pollen-robotics/elec_battery_mngt/README.md

# Battery-related Electronic Boards

This repository gathers several small PCBs for battery management. Including:

 - 2S BMS + USB-ish charger

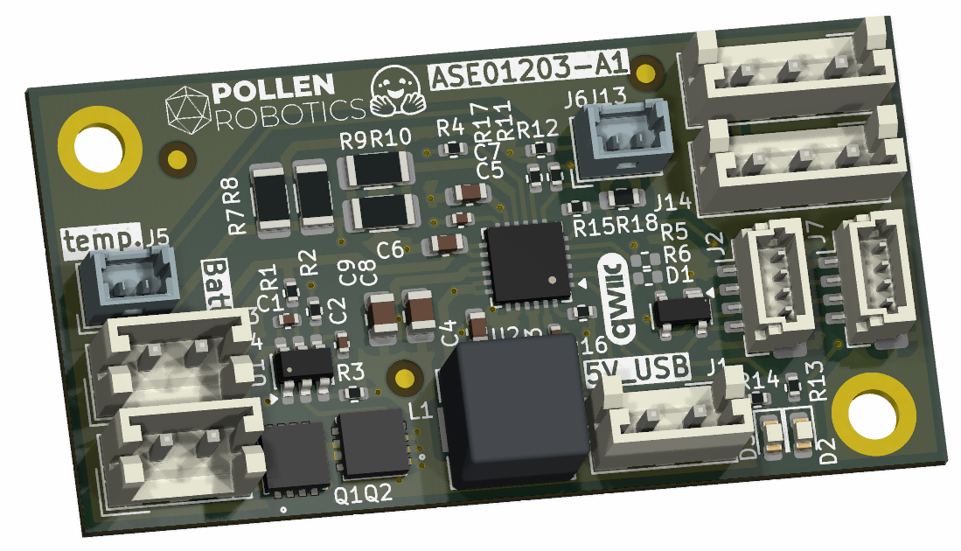
[picture p1: elec_2S_BMS_plus_charger/docs/img/elec_2S_BMS_plus_charger.png]
3d view


## Basically
 - Designed with KiCAD 9.
