pollen-robotics/elec_battery_mngt/elec_2S_BMS_plus_charger/docs/img/running.jpg

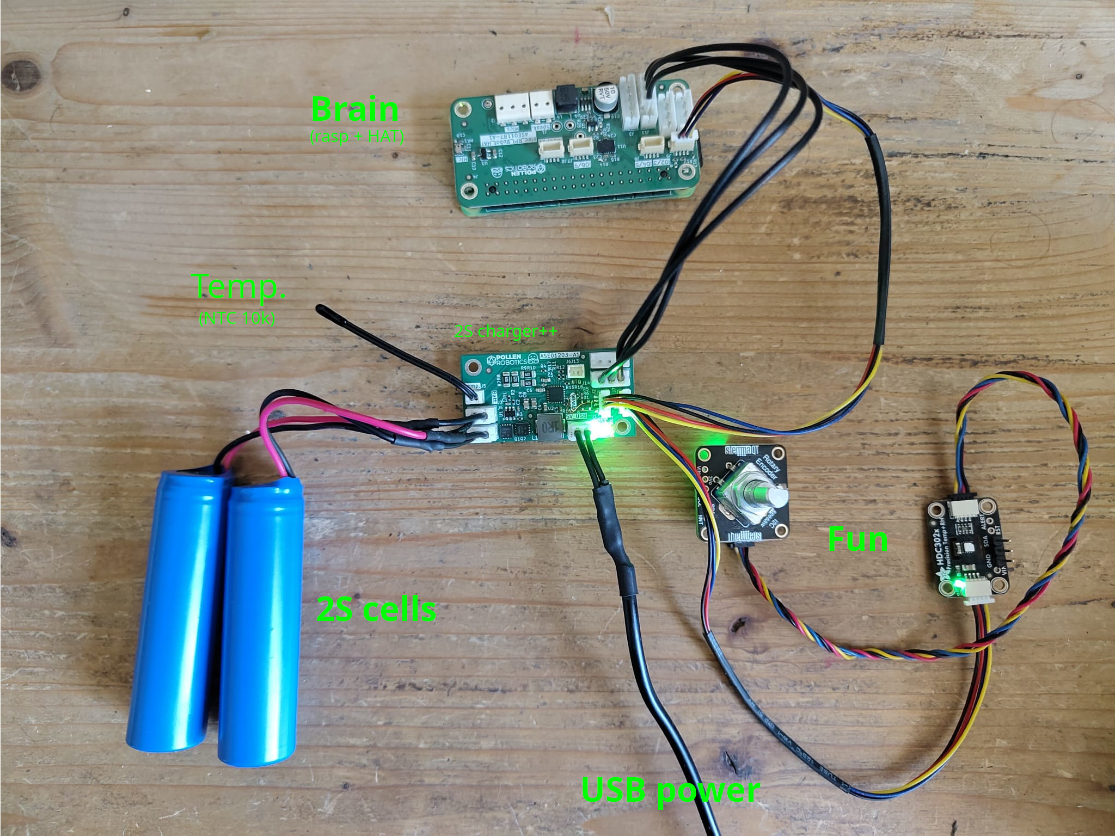
elec_2S_BMS_plus_charger/docs/img/running.jpg
