pollen-robotics/elec_battery_mngt/elec_2S_BMS_plus_charger/fab/elec_BMS_plus_charger.step

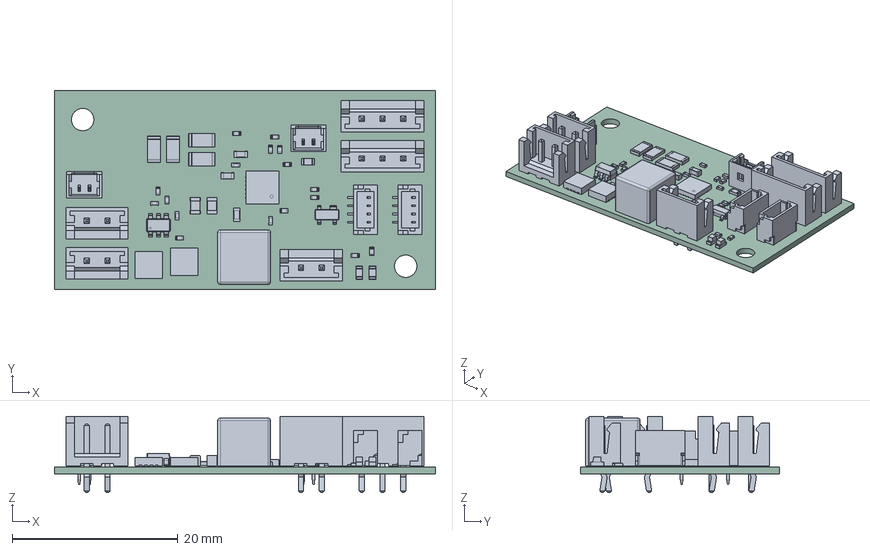
[picture p4: CAD file, 2026-04-30]
elec_2S_BMS_plus_charger/fab/elec_BMS_plus_charger.step
46.0 x 24.0 x 9.20 mm
R_1206_3216Metric x 4
LED_0603_1608Metric x 2
JST_EH_B2B-EH-A_1x02_P2.50mm_Vertical x 3
Molex_530470210 x 2
C_0805_2012Metric x 2
JST_SH_BM04B-SRSS-TB_1x04-1MP_P1.00mm_Vertical x 2
R_0402_1005Metric x 13
L_Bourns_SRP6060FA
SOT-23-6
C_0603_1608Metric x 3
BSZ034N04LS x 2
C_0402_1005Metric x 4
R_0603_1608Metric
Texas_RGE0024H_VQFN-24-1EP_4x4mm_P0.5mm_EP2.7x2.7mm
SOT-143
JST_EH_B3B-EH-A_1x03_P2.50mm_Vertical x 2
elec_BMS_plus_charger_PCB
