pollen-robotics/elec_battery_mngt/elec_2S_BMS_plus_charger/fab/elec_BMS_plus_charger.pdf

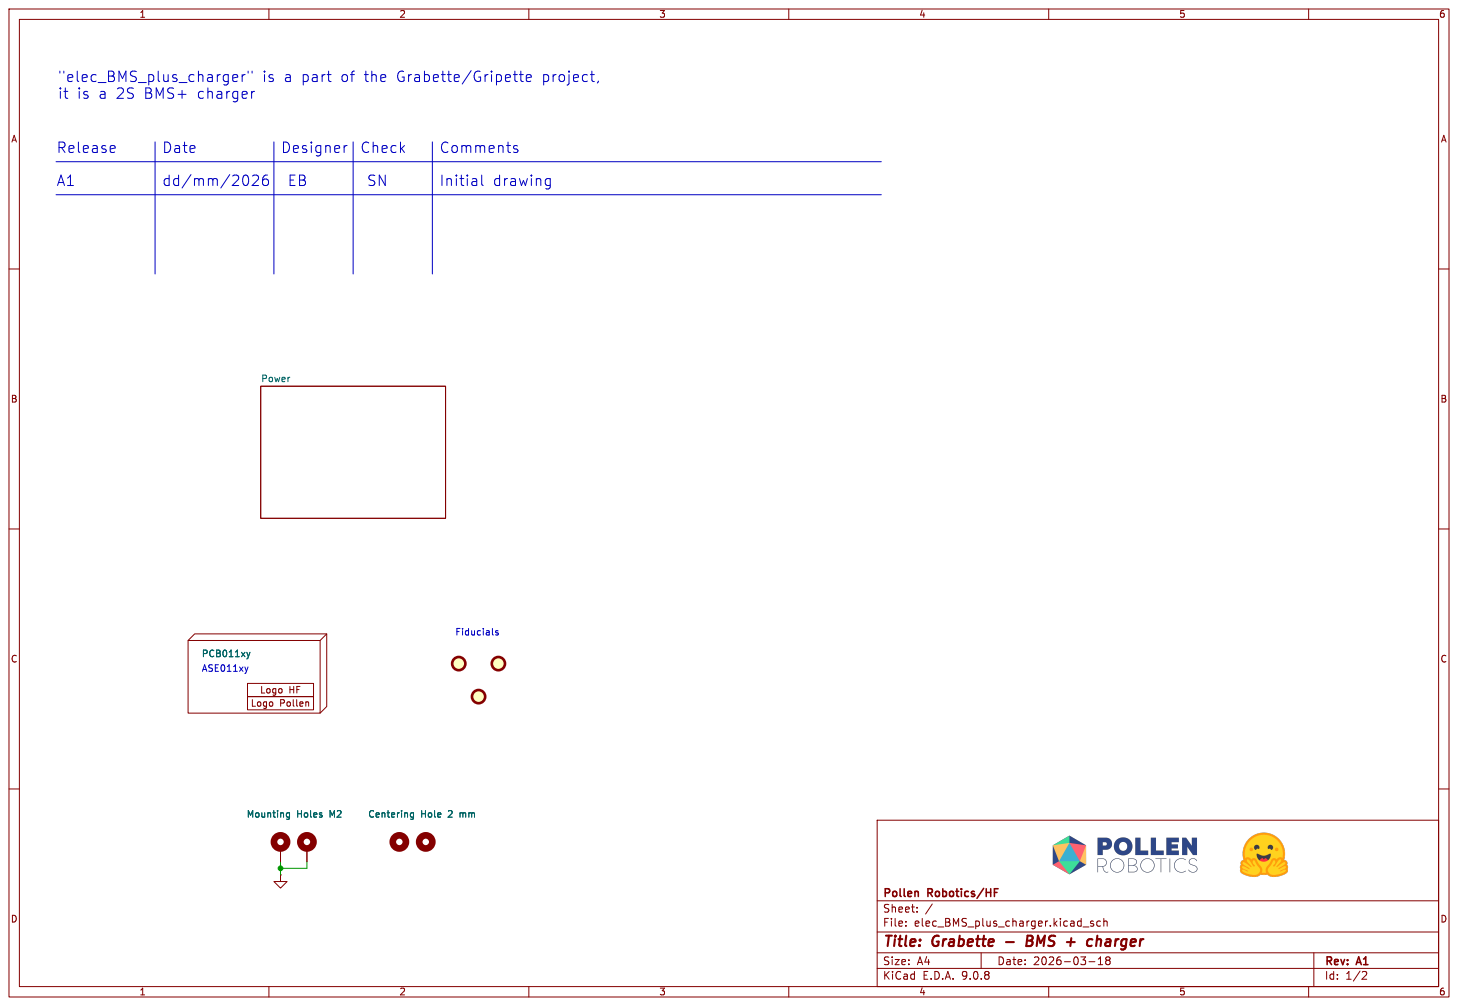
[picture p5: page 1]

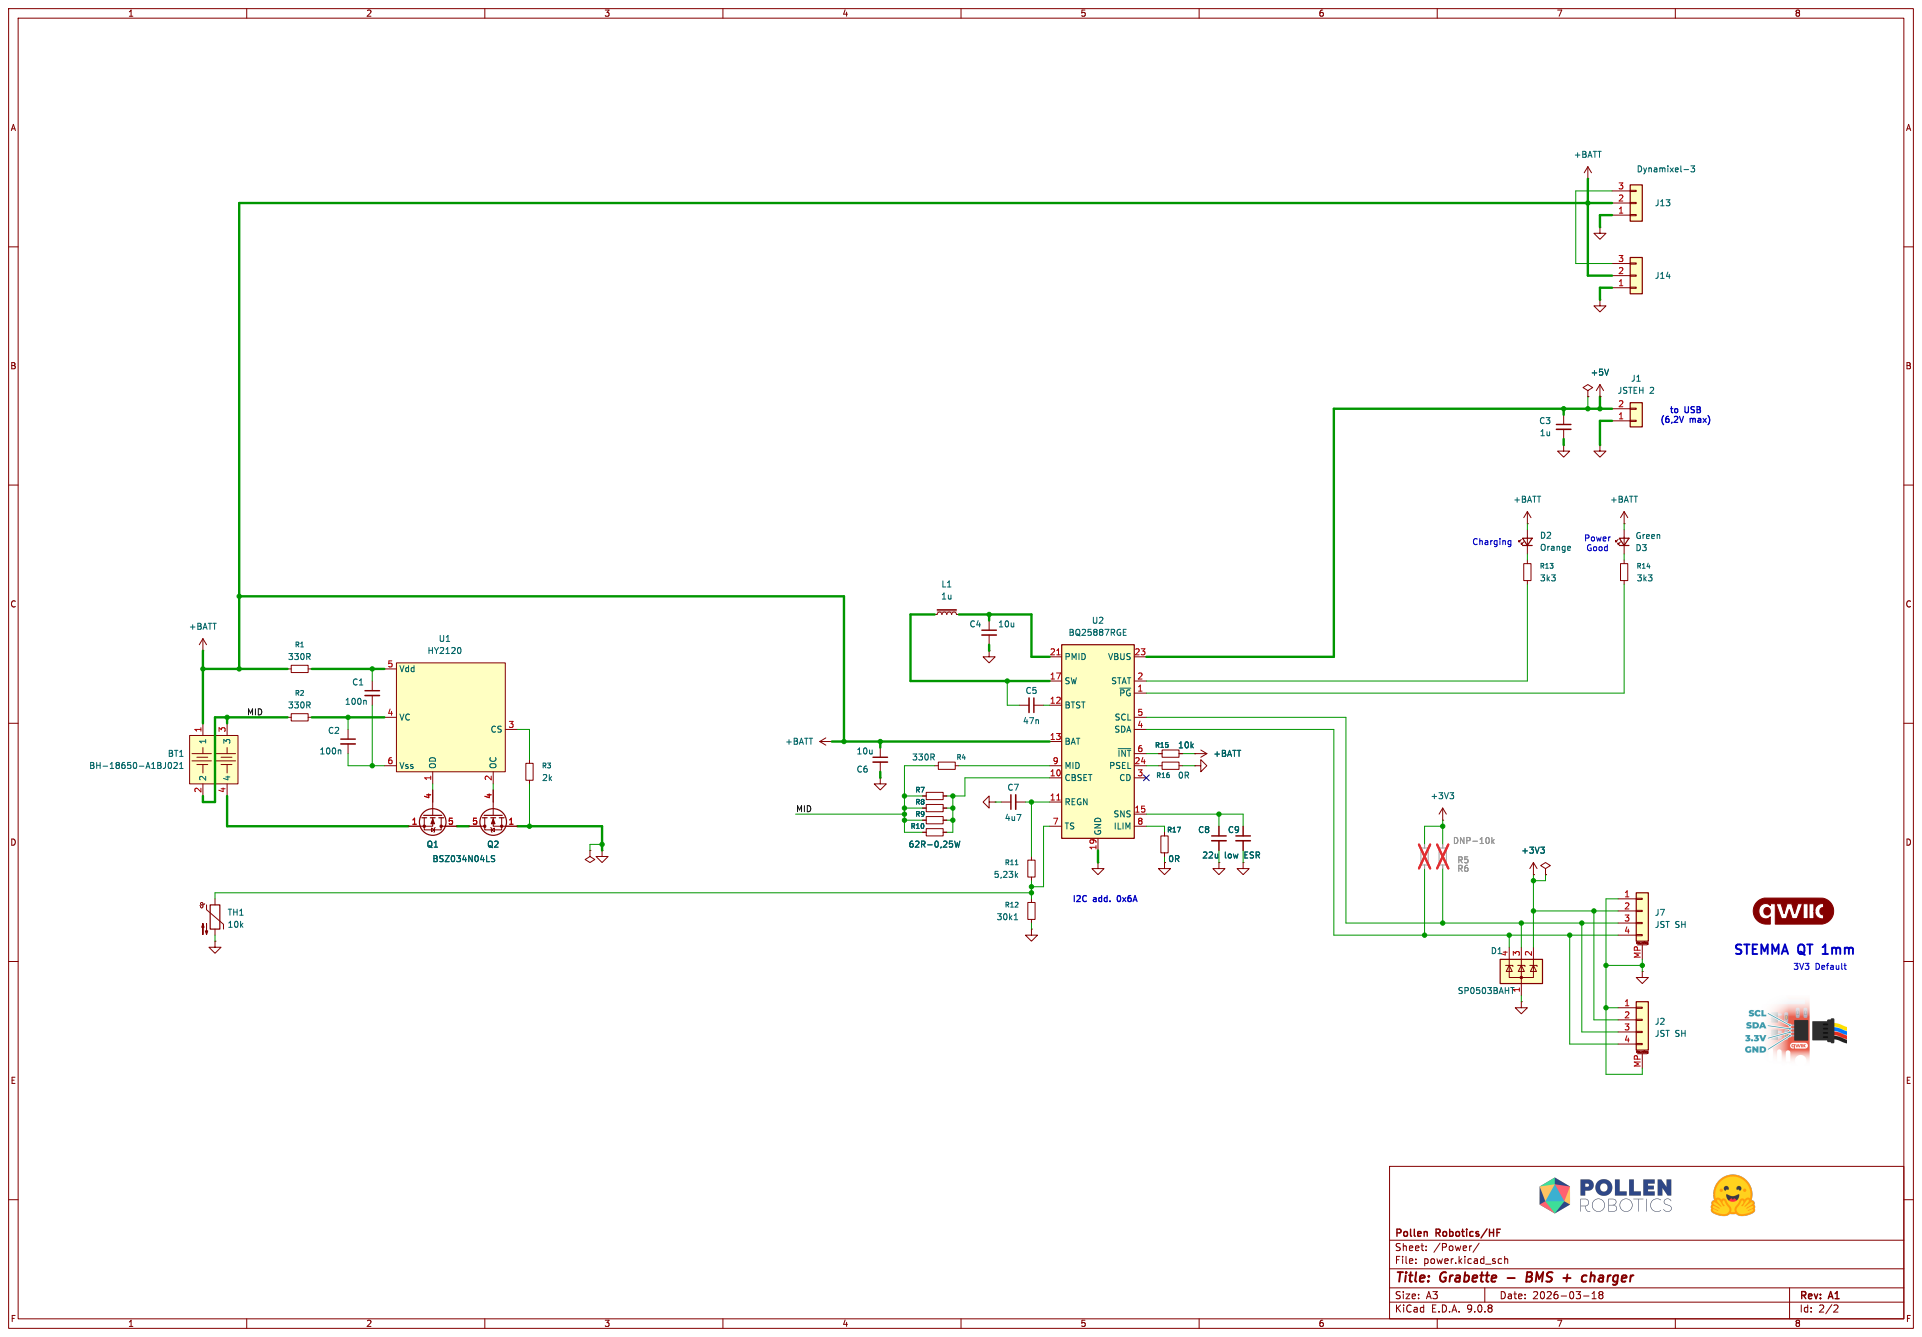
[picture p6: page 2]
