pollen-robotics/elec_battery_mngt/elec_2S_BMS_plus_charger/elec_BMS_plus_charger.kicad_pcb

## KiCad design elec_2S_BMS_plus_charger/elec_BMS_plus_charger.kicad_pcb (2026-08-10)

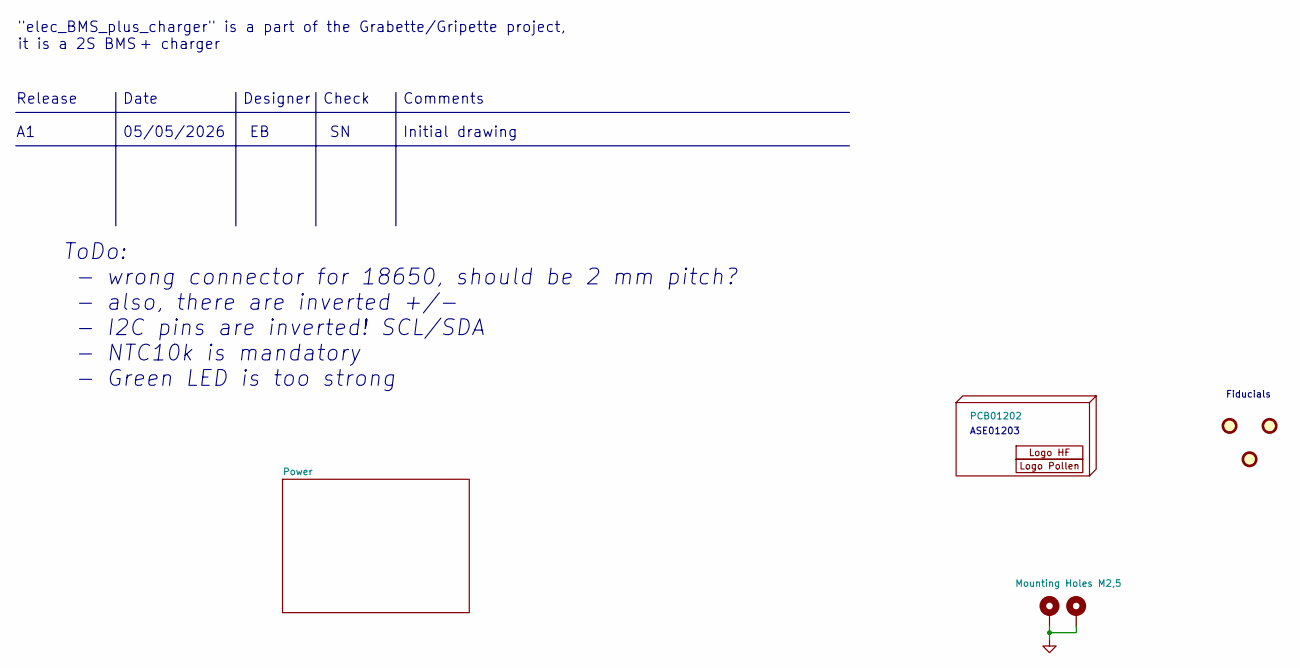
[picture p7: schematic elec_BMS_plus_charger.kicad_sch, Grabette - BMS + charger]

Parts:
FID1, FID2, FID3: DNP Fiducial; Fiducial_1mm_Mask2mm
H1: PCB01202
H2: Logo HF 2025; Logo_HF_2025
H3: DNP Logo Pollen 2021; Logo_Pollen_2021_sq
H4, H5: Mounting Holes M2,5; MountingHole_2.7mm_M2.5_ISO7380_Pad_TopBottom

Connections:
GND: H4.1, H5.1; also elsewhere on the board

Notes on the sheet:
Date
Check
Release
Fiducials
ASE01203
ToDo: - wrong connector for 18650, should be 2 mm pitch? - also, there are inverted +/- - I2C pins are inverted! SCL/SDA - NTC10k is mandatory - Green LED is too strong
Initial drawing
"elec_BMS_plus_charger" is a part of the Grabette/Gripette project, it is a 2S BMS + charger
Designer
Comments
05/05/2026

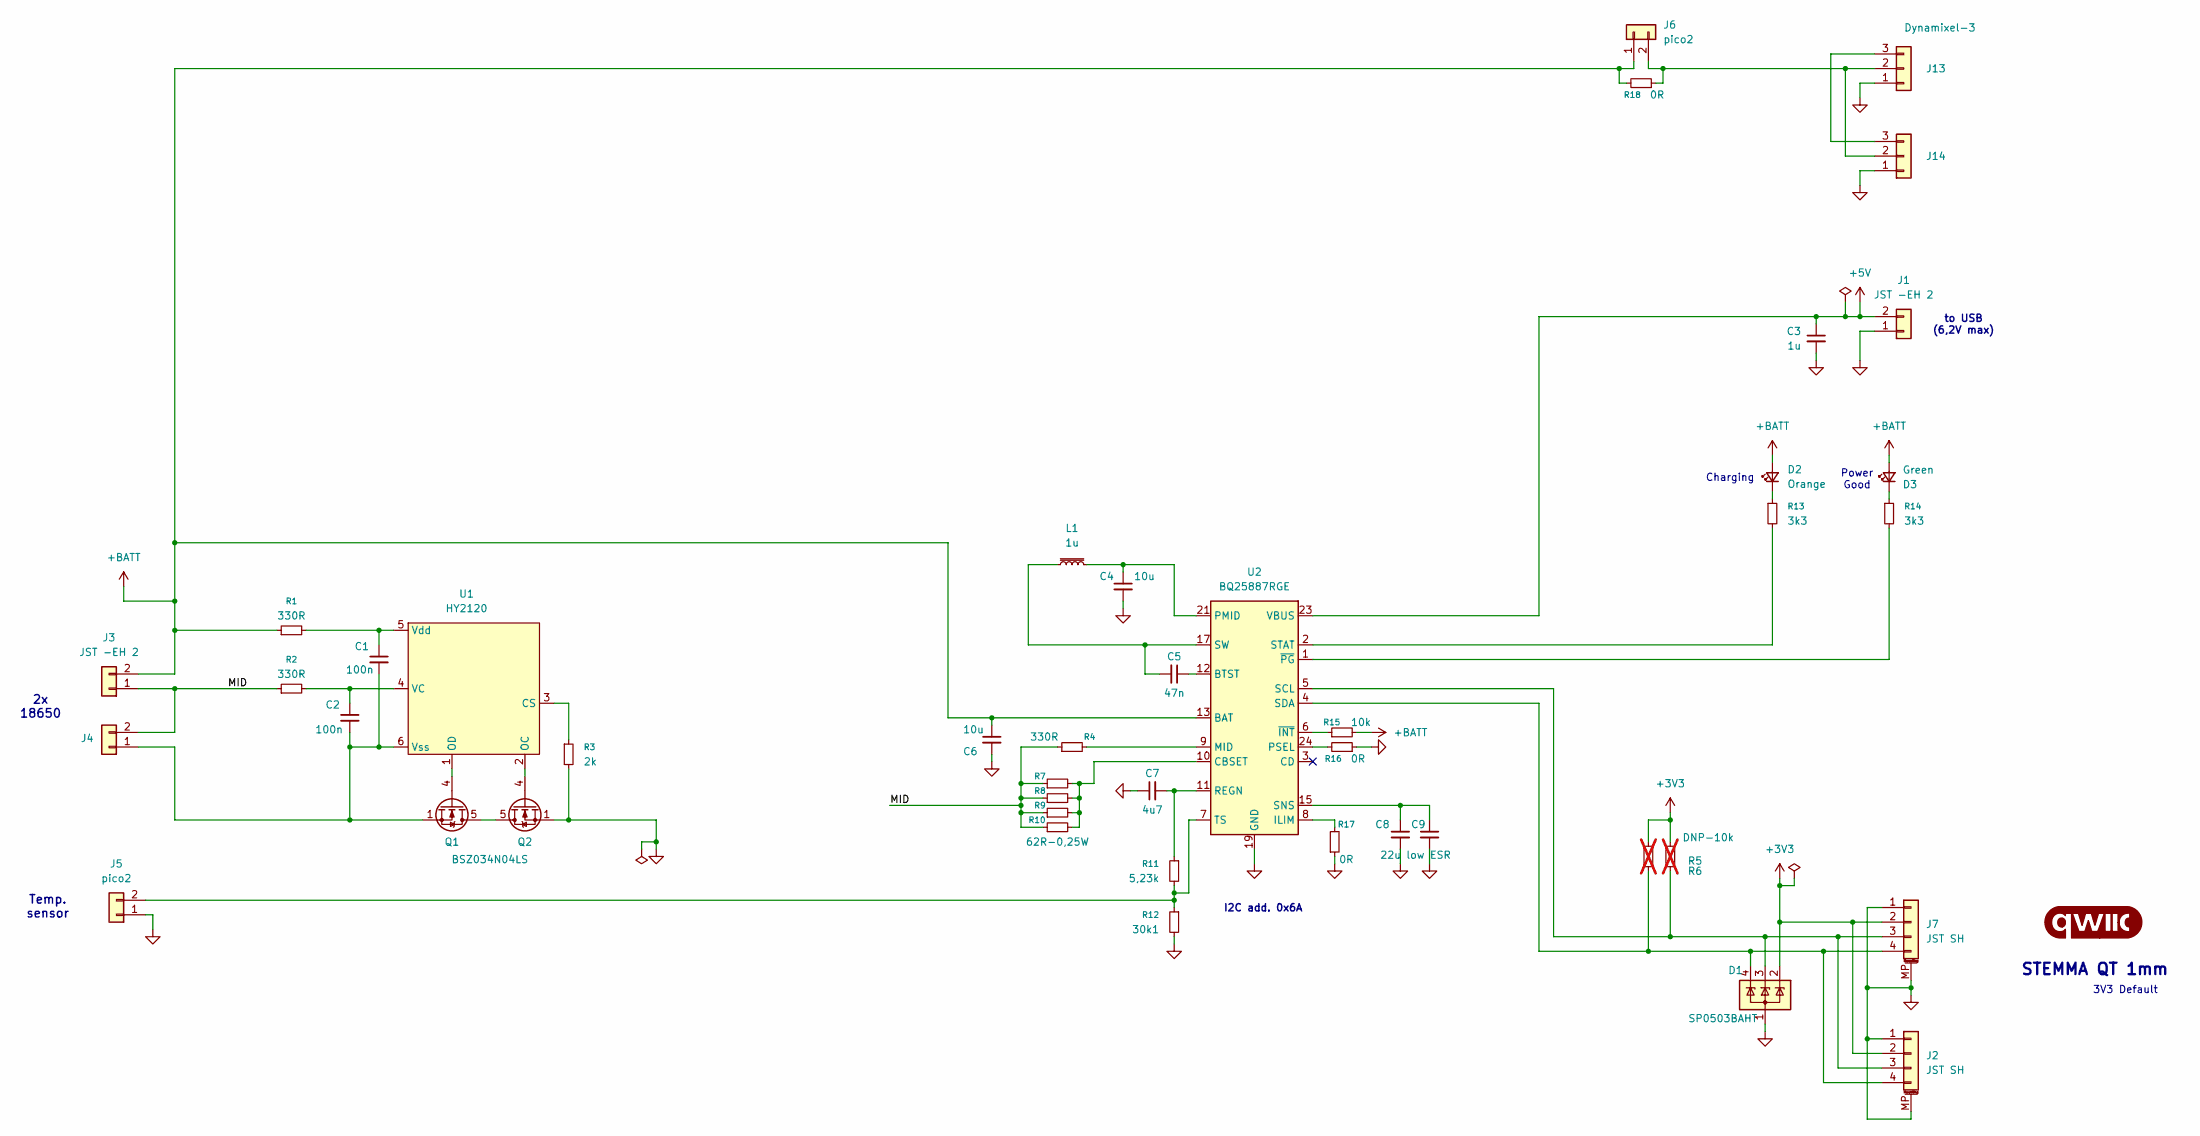
[picture p8: schematic power.kicad_sch, Grabette - BMS + charger]

Parts:
C1, C2: 100n; C_0402_1005Metric; LCSC Part C1525
C3: 1u; C_0402_1005Metric; LCSC Part C52923
C4, C6: 10u; C_0603_1608Metric; LCSC Part C19702
C5: 47n; C_0402_1005Metric; LCSC Part C272875
C7: 4u7; C_0603_1608Metric; LCSC Part C1705
C8, C9: 22u low ESR; C_0805_2012Metric; LCSC Part C5674
D1: SP0503BAHT; SOT-143; LCSC Part C41364459
D2: Orange; LED_0603_1608Metric; LCSC Part C84269
D3: Green; LED_0603_1608Metric; LCSC Part C19171301
G1: qwiic_Logo; Logo_qwiic_5mm
J1, J3, J4: JST -EH 2; JST_EH_B2B-EH-A_1x02_P2.50mm_Vertical; LCSC Part C160262
J2, J7: JST SH; JST_SH_BM04B-SRSS-TB_1x04-1MP_P1.00mm_Vertical; LCSC Part C160390
J5, J6: pico2; Molex_PicoBlade_53047-0210_1x02_P1.25mm_Vertical; LCSC Part C114130
J13, J14: Dynamixel-3; JST_EH_B3B-EH-A_1x03_P2.50mm_Vertical; LCSC Part C160259
L1: 1u; IND-SMD_L7.2-W6.6_GPSR0730; LCSC Part C5189744
Q1, Q2: BSZ034N04LS; PQFN_3.3x3.3mm_-_PG-TDSON-8_FL; LCSC Part C534652
R1, R2, R4: 330R; R_0402_1005Metric; LCSC Part C25104
R3: 2k; R_0402_1005Metric; LCSC Part C2909344
R5, R6: DNP-10k; R_0402_1005Metric; not fitted
R7, R8, R9, R10: 62R-0,25W; R_1206_3216Metric; LCSC Part C3013271
R11: 5,23k; R_0402_1005Metric; LCSC Part C2933105
R12: 30k1; R_0402_1005Metric; LCSC Part C2998131
R13, R14: 3k3; R_0402_1005Metric; LCSC Part C25890
R15: 10k; R_0402_1005Metric; LCSC Part C2906861
R16, R17: 0R; R_0402_1005Metric; LCSC Part C17168
R18: 0R; R_0603_1608Metric; LCSC Part C21189
U1: HY2120; SOT-23-6; LCSC Part C168778
U2: BQ25887RGE; Texas_RGE0024H_VQFN-24-1EP_4x4mm_P0.5mm_EP2.7x2.7mm; LCSC Part C2761614

Connections:
+3V3: D1.2 (K), J2.2, J7.2, R5.1, R6.1
+5V: C3.1, J1.2, U2.23 (VBUS)
+BATT: C6.1, D2.2 (A), D3.2 (A), J3.2, J6.1, R1.1, R15.2, R18.2, U2.13 (BAT), U2.14 (BAT)
/Power/MID: J3.1, J4.2, R2.1, R4.1, R7.1, R8.1, R9.1, R10.1
GND: C3.2, C4.2, C6.2, C7.1, C8.2, C9.2, D1.1 (A), J1.1, J2.1, J2.MP (MountPin), J5.1, J7.1, J7.MP (MountPin), J13.1, J14.1, Q2.1 (S), R3.2, R12.2, R16.1, R17.1, U2.19 (GND), U2.20 (GND), U2.25 (GND); also elsewhere on the board
unnamed: C4.1, L1.2, U2.21 (PMID), U2.22 (PMID)
unnamed: C5.2, L1.1, U2.17 (SW), U2.18 (SW)
unnamed: C8.1, C9.1, U2.15 (SNS), U2.16 (SNS)
unnamed: D2.1 (K), R13.1
unnamed: D3.1 (K), R14.1
unnamed: D1.3 (K), J2.3, J7.3, R5.2, U2.5 (SCL)
unnamed: D1.4 (K), J2.4, J7.4, R6.2, U2.4 (SDA)
unnamed: C1.2, C2.2, J4.1, Q1.1 (S), U1.6 (Vss)
unnamed: J5.2, R11.2, R12.1, U2.7 (TS)
unnamed: J6.2, J13.2, J14.2, R18.1
unnamed: J13.3, J14.3
unnamed: Q1.5 (D), Q2.5 (D)
unnamed: Q1.4 (G), U1.1 (OD)
unnamed: Q2.4 (G), U1.2 (OC)
unnamed: R3.1, U1.3 (CS)
unnamed: C2.1, R2.2, U1.4 (VC)
unnamed: C1.1, R1.2, U1.5 (Vdd)
unnamed: C5.1, U2.12 (BTST)
unnamed: R7.2, R8.2, R9.2, R10.2, U2.10 (CBSET)
unnamed: R17.2, U2.8 (ILIM)
unnamed: R4.2, U2.9 (MID)
unnamed: R16.2, U2.24 (PSEL)
unnamed: C7.2, R11.1, U2.11 (REGN)
unnamed: R13.2, U2.2 (STAT)
unnamed: R15.1, U2.6 (~INT)
unnamed: R14.2, U2.1 (~PG)

Notes on the sheet:
Power Good
to USB (6,2V max)
STEMMA QT 1mm
I2C add. 0x6A
Charging
2x 18650
Temp. sensor
3V3 Default

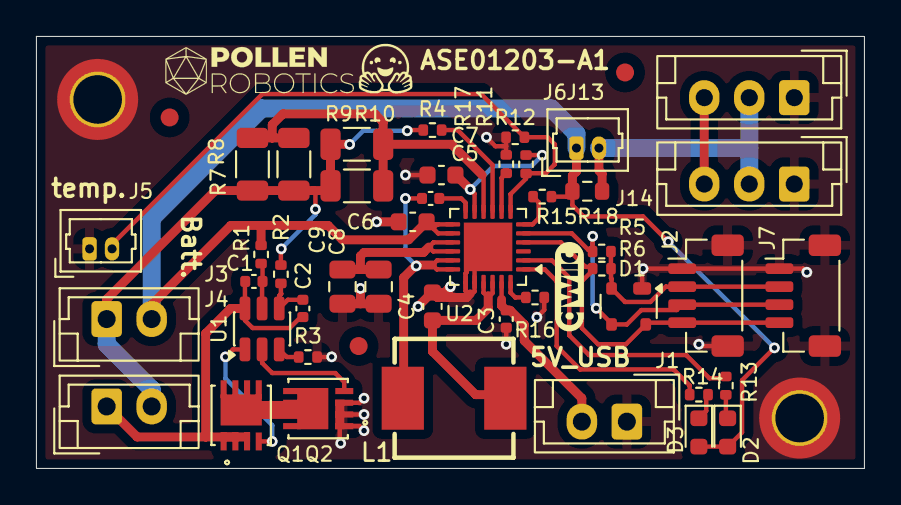
[picture p9: board elec_BMS_plus_charger.kicad_pcb from above]

Board: 2 copper layers, 46.0 x 24.0 mm, 52 parts (0 on the bottom side), 31 nets.
