pollen-robotics/elec_battery_mngt/(commit log)

2026-04-30 [init] Splitting projets and setting this repo for battery stuff.
    [elec_BMS_plus_charger.kicad_pcb, elec_BMS_plus_charger.kicad_sch, elec_BMS_plus_charger.step, power.kicad_sch]
2026-05-05 [update] Release A1, small batch of 15 @JLCPCB
    [elec_BMS_plus_charger.kicad_pcb, elec_BMS_plus_charger.kicad_sch, power.kicad_sch]
2026-05-06 [added] Image
    [elec_BMS_plus_charger.kicad_sch]
2026-08-10 [update] Now running test on rasp zero 2W + HAT
    [elec_BMS_plus_charger.kicad_pcb, elec_BMS_plus_charger.kicad_sch, power.kicad_sch]
